ziimiin14/event_cam_project/cad/dvs_assembly_w_odroid.SLDASM

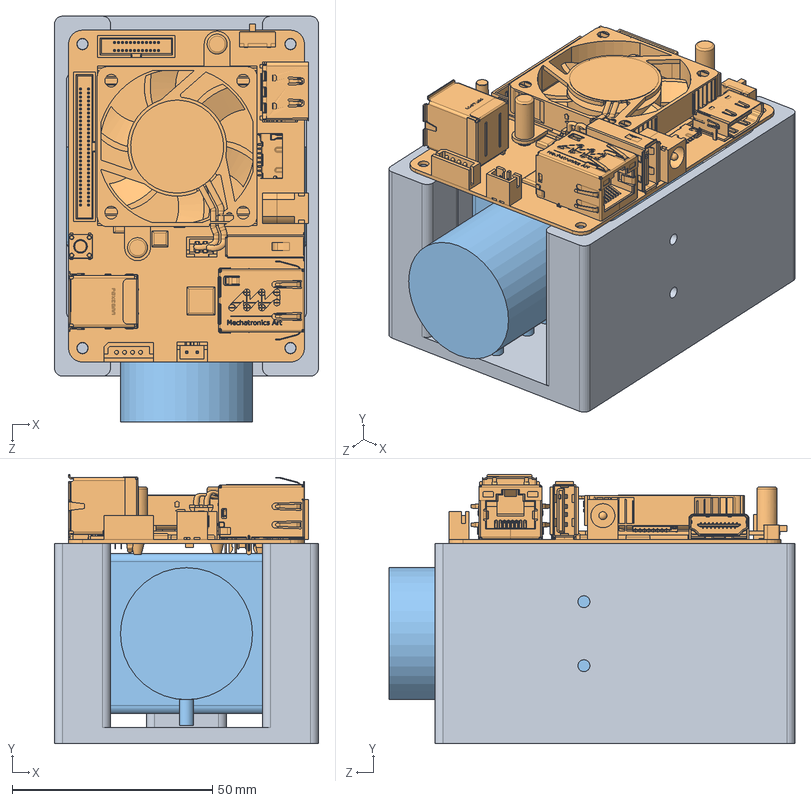
[picture p20: CAD file, 2020-07-20]
cad/dvs_assembly_w_odroid.SLDASM
66.0 x 67.3 x 101.5 mm
new_mount
Odroid-XU4
DVS240
