ziimiin14/event_cam_project/cad/mount_lattepanda_alpha_1.SLDPRT

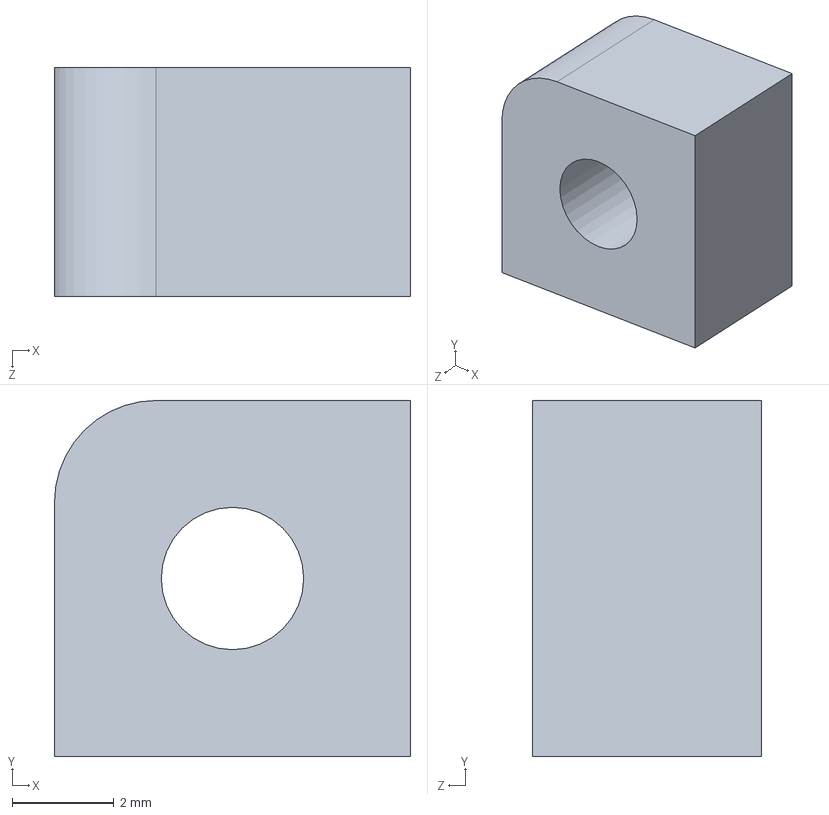
[picture p21: CAD file, 2020-07-20]
cad/mount_lattepanda_alpha_1.SLDPRT
7.00 x 7.00 x 4.50 mm
