ziimiin14/event_cam_project/Handover files (Siraaj)/Rotational rig 3D parts/Base/Encoder Plate.SLDPRT

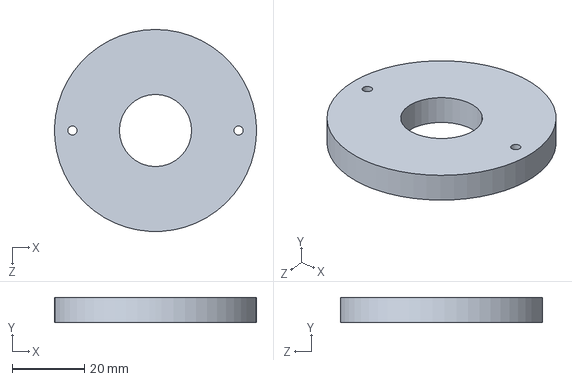
[picture p22: CAD file, 2020-07-20]
Handover files (Siraaj)/Rotational rig 3D parts/Base/Encoder Plate.SLDPRT
56.0 x 7.00 x 56.0 mm
