ziimiin14/event_cam_project/Handover files (Siraaj)/Rotational rig 3D parts/Jaw liner/TPU Lower jaw liner (Orth mount).SLDPRT

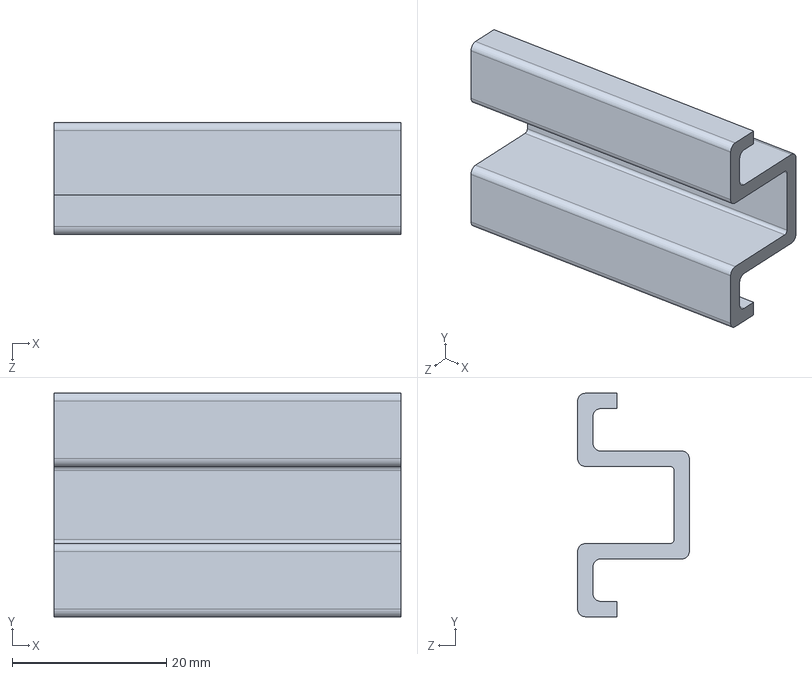
[picture p23: CAD file, 2020-07-20]
Handover files (Siraaj)/Rotational rig 3D parts/Jaw liner/TPU Lower jaw liner (Orth mount).SLDPRT
45.0 x 29.0 x 14.5 mm
