ziimiin14/event_cam_project/Handover files (Siraaj)/Rotational rig 3D parts/Jaw/Orthogonal Mount (Slot).SLDPRT

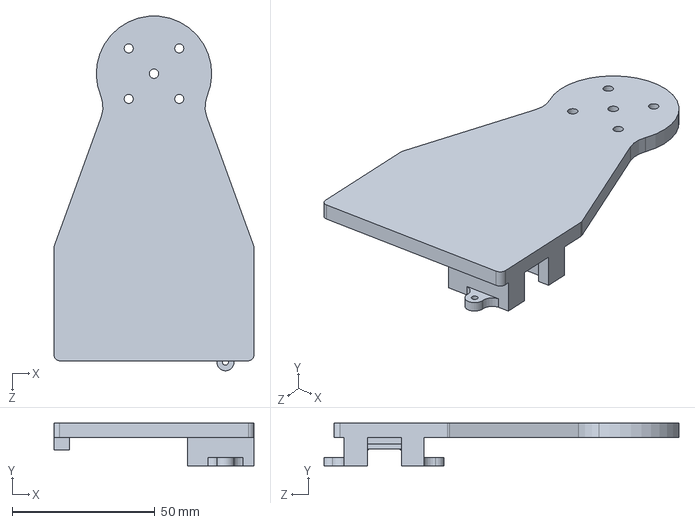
[picture p24: CAD file, 2020-07-20]
Handover files (Siraaj)/Rotational rig 3D parts/Jaw/Orthogonal Mount (Slot).SLDPRT
70.0 x 15.0 x 124.1 mm
