ziimiin14/event_cam_project/Handover files (Siraaj)/Rotational rig 3D parts/Shaft/Rot.Rig shaft hub.SLDPRT

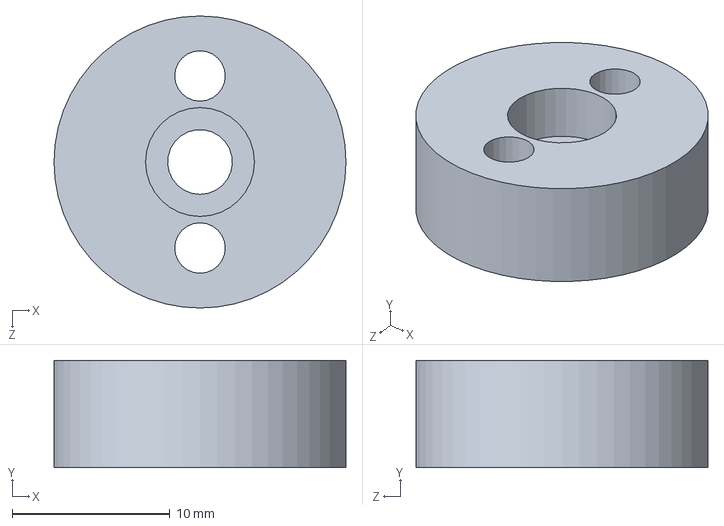
[picture p25: CAD file, 2020-07-20]
Handover files (Siraaj)/Rotational rig 3D parts/Shaft/Rot.Rig shaft hub.SLDPRT
18.5 x 6.78 x 18.5 mm
