ziimiin14/event_cam_project/cad/new_mount.SLDPRT

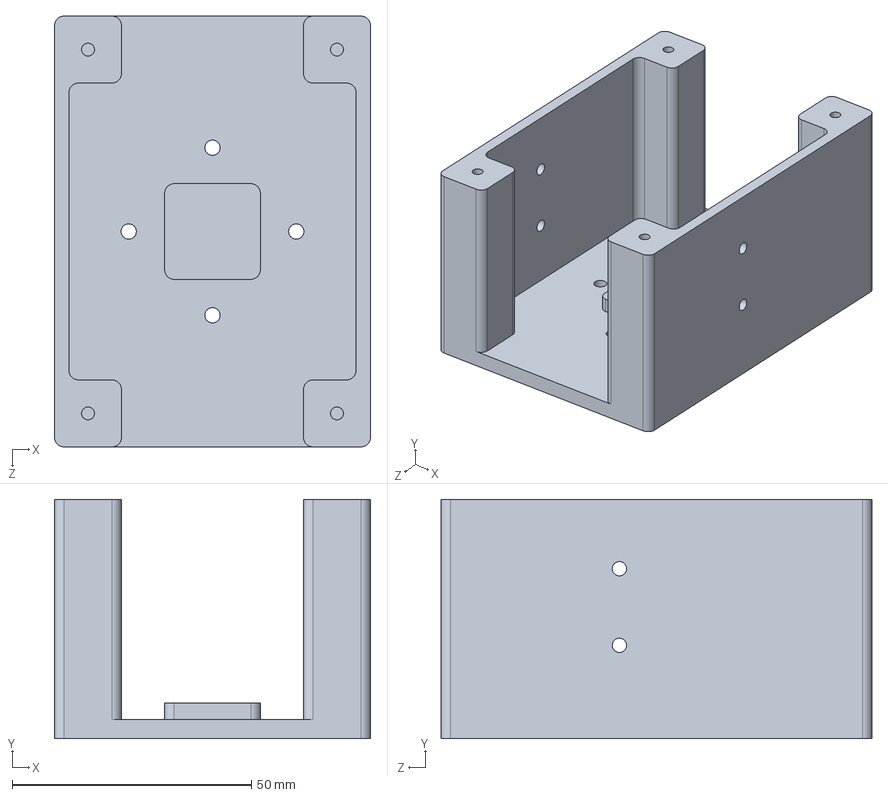
[picture p26: CAD file, 2020-07-20]
cad/new_mount.SLDPRT
66.0 x 50.0 x 90.0 mm
