ziimiin14/event_cam_project/Handover files (Siraaj)/Rotational rig 3D parts/Base/Markforged Rot Rig Base.SLDPRT

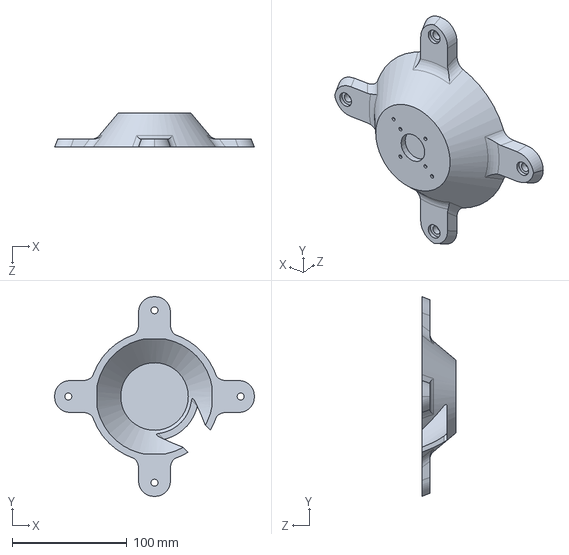
[picture p27: CAD file, 2020-07-20]
Handover files (Siraaj)/Rotational rig 3D parts/Base/Markforged Rot Rig Base.SLDPRT
174.0 x 174.0 x 30.0 mm
