ziimiin14/event_cam_project/Handover files (Siraaj)/Rotational rig 3D parts/Jaw/Orthogonal mount (BB) upper jaw (final).SLDPRT

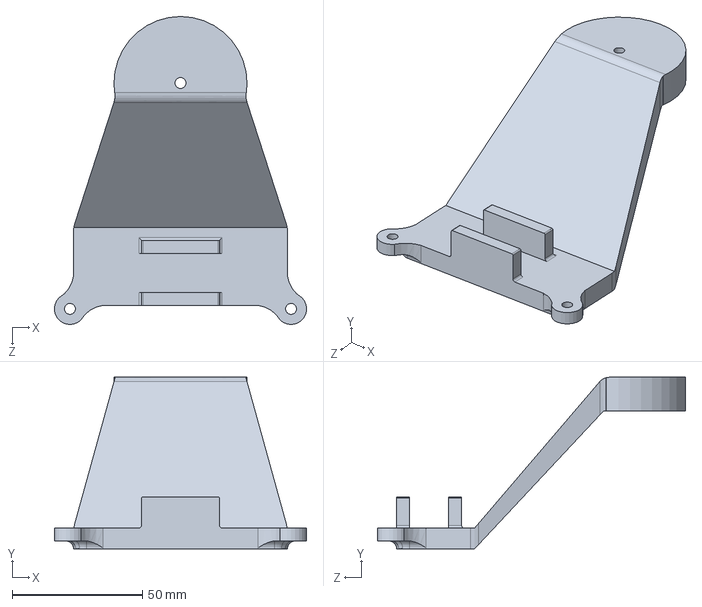
[picture p29: CAD file, 2020-07-20]
Handover files (Siraaj)/Rotational rig 3D parts/Jaw/Orthogonal mount (BB) upper jaw (final).SLDPRT
97.0 x 66.0 x 118.4 mm
