ziimiin14/event_cam_project/Handover files (Siraaj)/Rotational rig 3D parts/Weight mount & attachments/Motion tracker bar (final).SLDPRT

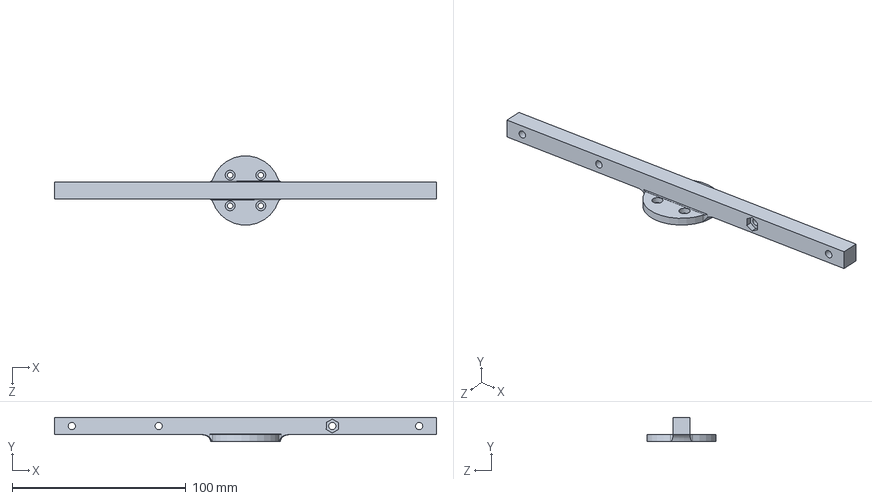
[picture p30: CAD file, 2020-07-20]
Handover files (Siraaj)/Rotational rig 3D parts/Weight mount & attachments/Motion tracker bar (final).SLDPRT
220.0 x 14.0 x 39.7 mm
