ziimiin14/event_cam_project/cad/mount.SLDPRT

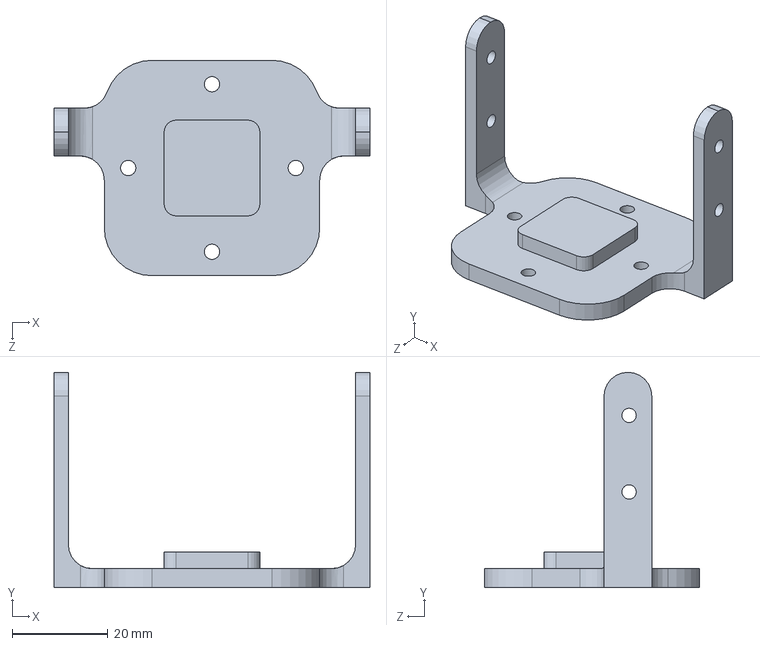
[picture p31: CAD file, 2020-07-20]
cad/mount.SLDPRT
66.0 x 45.0 x 45.0 mm
