ziimiin14/event_cam_project/Handover files (Siraaj)/Rotational rig 3D parts/Jaw/Orthogonal mount (BB) lower jaw.SLDPRT

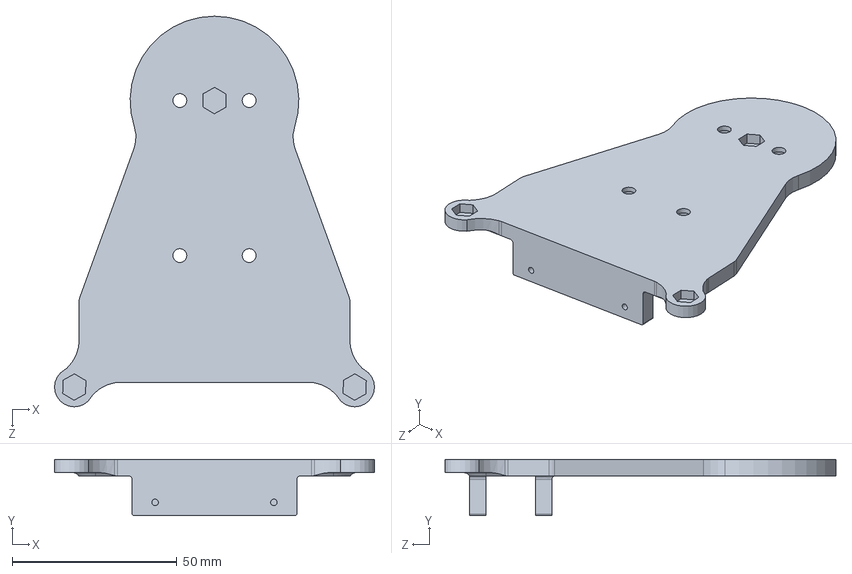
[picture p32: CAD file, 2020-07-20]
Handover files (Siraaj)/Rotational rig 3D parts/Jaw/Orthogonal mount (BB) lower jaw.SLDPRT
97.0 x 17.0 x 118.4 mm
