ziimiin14/event_cam_project/Handover files (Siraaj)/Rotational rig 3D parts/Weight mount & attachments/Armature (Rig side).SLDPRT

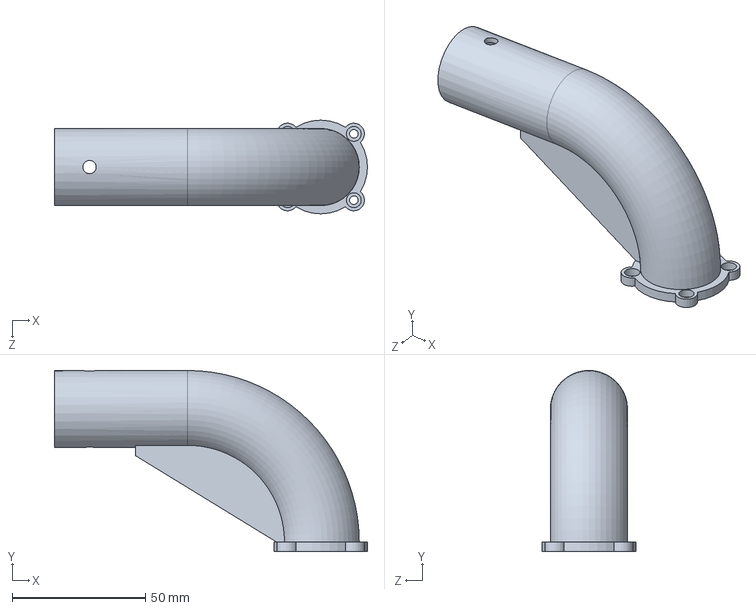
[picture p33: CAD file, 2020-07-20]
Handover files (Siraaj)/Rotational rig 3D parts/Weight mount & attachments/Armature (Rig side).SLDPRT
117.6 x 68.0 x 35.2 mm
