ziimiin14/event_cam_project/cad/DVS240.SLDPRT

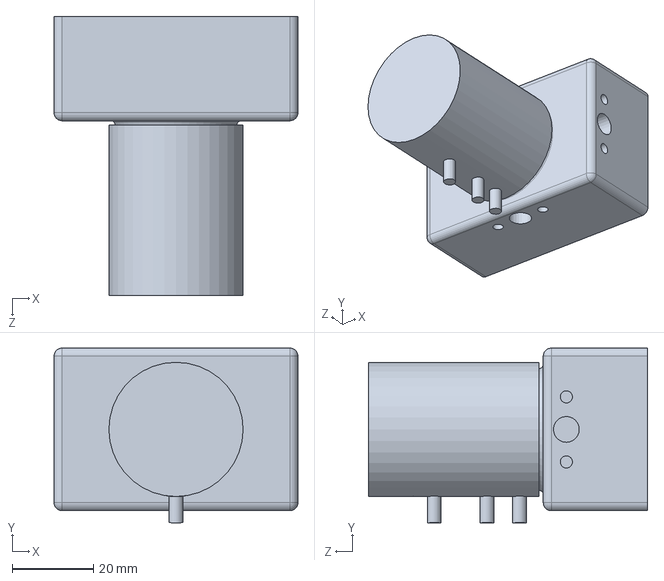
[picture p34: CAD file, 2020-07-20]
cad/DVS240.SLDPRT
60.0 x 43.0 x 68.7 mm
