ziimiin14/event_cam_project/Handover files (Siraaj)/Rotational rig 3D parts/Weight mount & attachments/Armature (Sensor-side).SLDPRT

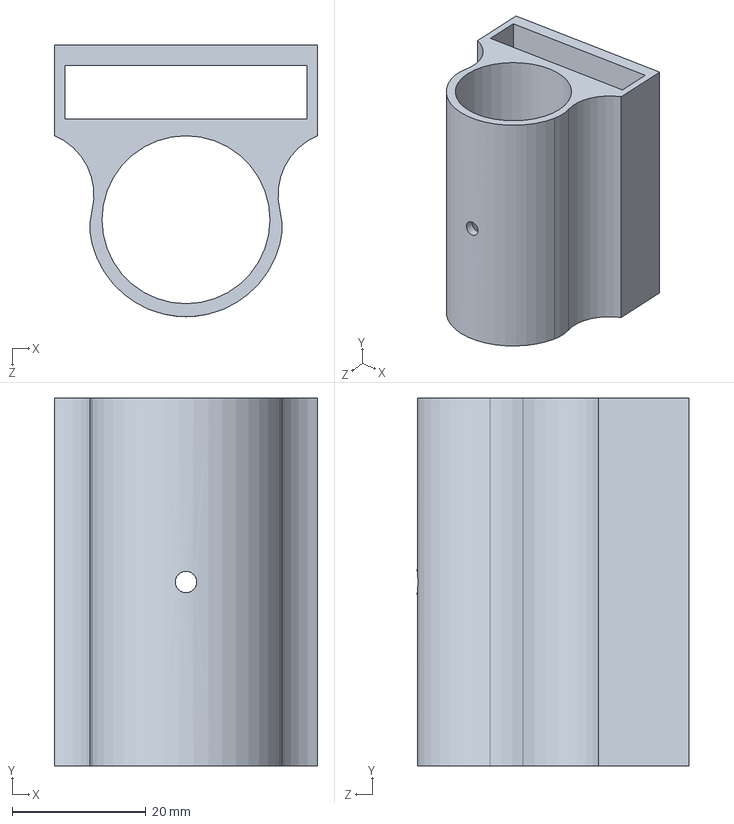
[picture p35: CAD file, 2020-07-20]
Handover files (Siraaj)/Rotational rig 3D parts/Weight mount & attachments/Armature (Sensor-side).SLDPRT
39.3 x 55.0 x 40.6 mm
