ziimiin14/event_cam_project/cad/new_mount_lattepanda_alpha.SLDPRT

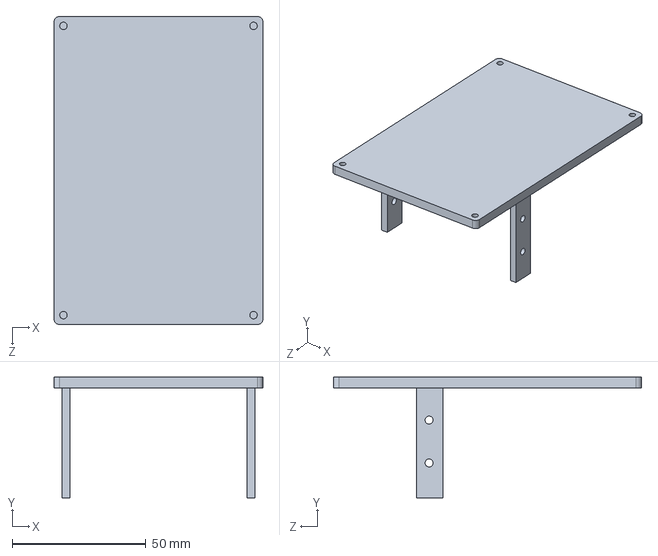
[picture p36: CAD file, 2020-07-20]
cad/new_mount_lattepanda_alpha.SLDPRT
78.0 x 45.0 x 115.0 mm
