ziimiin14/event_cam_project/Handover files (Siraaj)/Rotational rig 3D parts/Weight mount & attachments/Weight mount (Final).SLDPRT

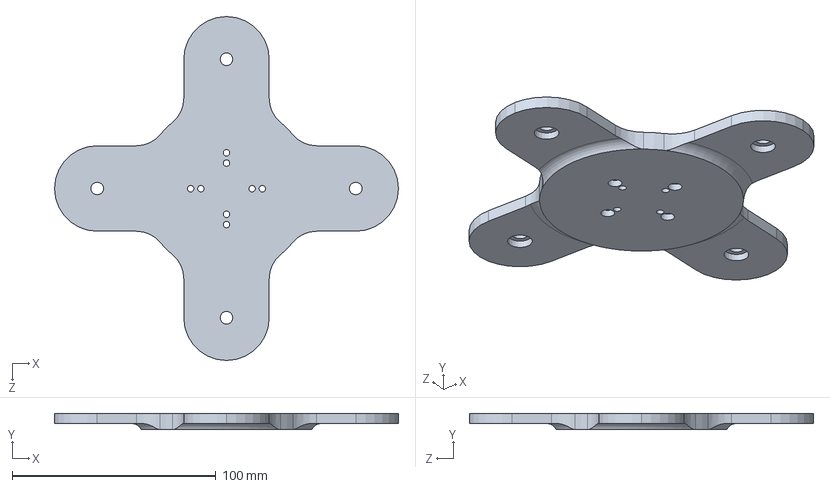
[picture p37: CAD file, 2020-07-20]
Handover files (Siraaj)/Rotational rig 3D parts/Weight mount & attachments/Weight mount (Final).SLDPRT
169.0 x 8.00 x 169.0 mm
