ziimiin14/event_cam_project/cad/new_mount_lattepanda_v1.SLDPRT

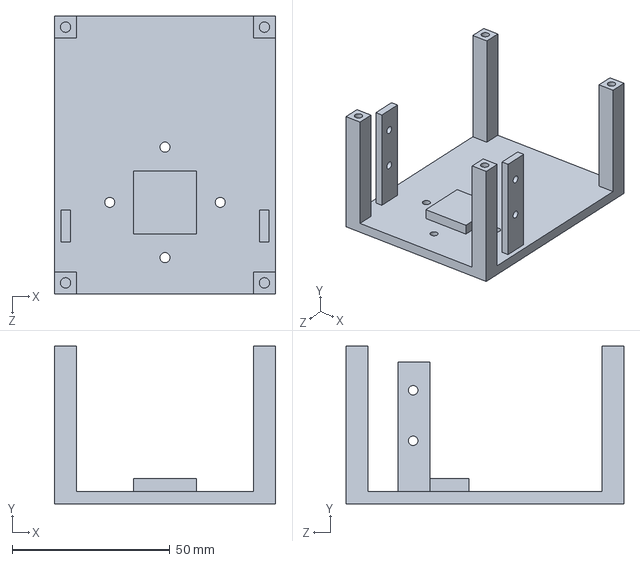
[picture p38: CAD file, 2020-07-20]
cad/new_mount_lattepanda_v1.SLDPRT
70.0 x 50.0 x 88.0 mm
