ziimiin14/event_cam_project/(list of files, cad)

Other CAD files:
Handover files (Siraaj)/Rotational rig 3D parts/Base/Encoder Plate.STL
Handover files (Siraaj)/Rotational rig 3D parts/Base/Markforged Rot Rig Base.STL
Handover files (Siraaj)/Rotational rig 3D parts/Jaw liner/TPU Lower jaw liner (Orth mount).STL
Handover files (Siraaj)/Rotational rig 3D parts/Jaw liner/TPU Upper jaw liner (Orth mount).STL
Handover files (Siraaj)/Rotational rig 3D parts/Jaw/Orthogonal Mount (Slot).STL
Handover files (Siraaj)/Rotational rig 3D parts/Jaw/Orthogonal mount (BB) lower jaw.STL
Handover files (Siraaj)/Rotational rig 3D parts/Jaw/Orthogonal mount (BB) upper jaw (final).STL
Handover files (Siraaj)/Rotational rig 3D parts/Shaft/Rot.Rig shaft hub.STL
Handover files (Siraaj)/Rotational rig 3D parts/Weight mount & attachments/Armature (Rig side).STL
Handover files (Siraaj)/Rotational rig 3D parts/Weight mount & attachments/Armature (Sensor-side).STL
Handover files (Siraaj)/Rotational rig 3D parts/Weight mount & attachments/Markforged washer.SLDPRT
Handover files (Siraaj)/Rotational rig 3D parts/Weight mount & attachments/Markforged washer.STL
Handover files (Siraaj)/Rotational rig 3D parts/Weight mount & attachments/Motion tracker bar (final).STL
Handover files (Siraaj)/Rotational rig 3D parts/Weight mount & attachments/Weight mount (Final).STL
