ziimiin14/event_cam_project/(commit log)

2020-07-20 new respository
    [DVS240.SLDPRT, dvs_assembly_w_odroid.SLDASM, mount.SLDPRT, mount_lattepanda_alpha_1.SLDPRT, new_mount.SLDPRT, new_mount_lattepanda_alpha.SLDPRT, new_mount_lattepanda_v1.SLDPRT]
2020-07-20 handover files
    [Armature (Rig side).SLDPRT, Armature (Rig side).STL, Armature (Sensor-side).SLDPRT, Armature (Sensor-side).STL, Encoder Plate.SLDPRT, Encoder Plate.STL, Lookup table for rotational rig.xlsx, Markforged Rot Rig Base.SLDPRT]
